Michael-Q-Ly/PlantHumidifier/Hardware/PlantHumidifier/Images/Ducky.bmp

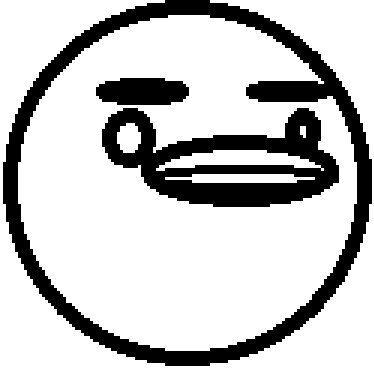
Hardware/PlantHumidifier/Images/Ducky.bmp
