Michael-Q-Ly/PlantHumidifier/Hardware/PlantHumidifier/PlantHumidifier.kicad_pcb

## KiCad design Hardware/PlantHumidifier/PlantHumidifier.kicad_pcb (2023-01-14)

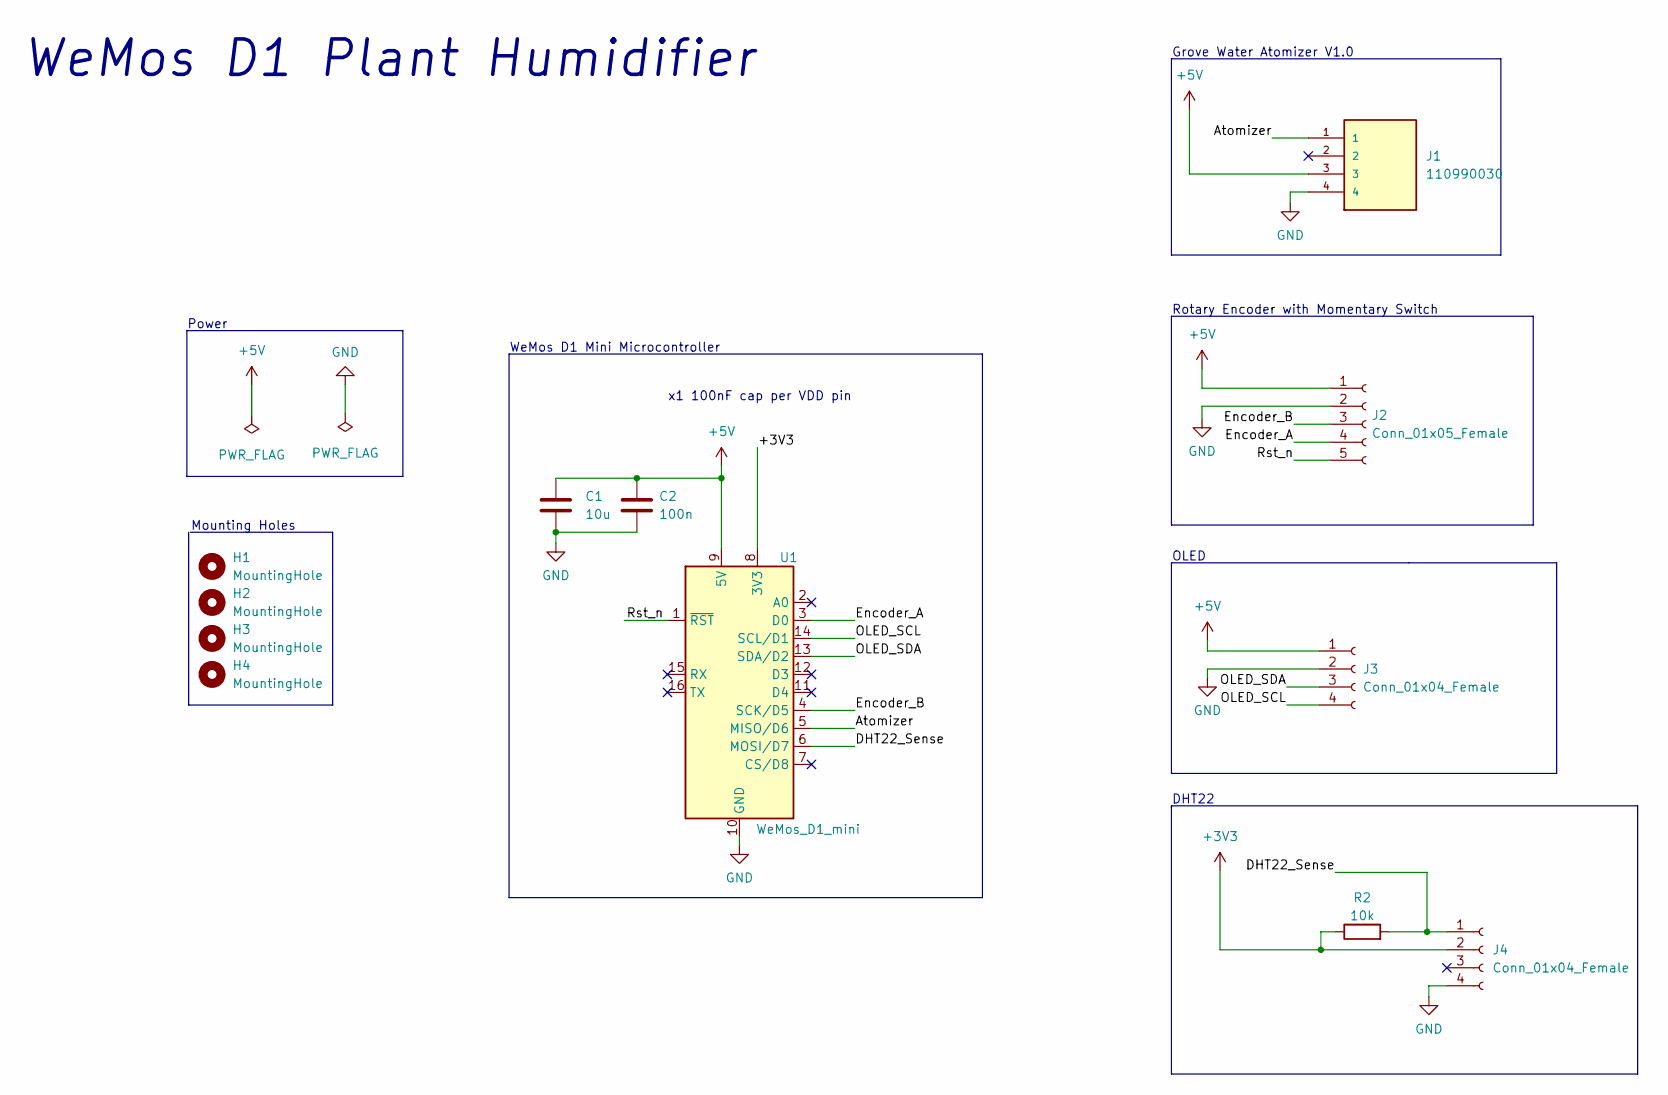
[picture p2: schematic PlantHumidifier.kicad_sch, Plant Humidifier]

Parts:
C1: 10u; C_0603_1608Metric
C2: 100n; C_0402_1005Metric
H1, H2, H3, H4: MountingHole; MountingHole_2.2mm_M2
J1: 110990030; SEEED_110990030; PARTREV A
J2: Conn_01x05_Female; JST_XH_B5B-XH-A_1x05_P2.50mm_Vertical
J3, J4: Conn_01x04_Female; JST_XH_B4B-XH-A_1x04_P2.50mm_Vertical
R2: 10k; R_0402_1005Metric
U1: WeMos_D1_mini; WEMOS_D1_mini_light

Connections:
+3V3: J4.2, R2.1, U1.8 (3V3)
+5V: C1.1, C2.1, J1.3, J2.1, J3.1, U1.9 (5V)
/Atomizer: J1.1, U1.5 (MISO/D6)
/DHT22_Sense: J4.1, R2.2, U1.6 (MOSI/D7)
/Encoder_A: J2.4, U1.3 (D0)
/Encoder_B: J2.3, U1.4 (SCK/D5)
/OLED_SCL: J3.4, U1.14 (SCL/D1)
/OLED_SDA: J3.3, U1.13 (SDA/D2)
/Rst_n: J2.5, U1.1 (~RST)
GND: C1.2, C2.2, J1.4, J2.2, J3.2, J4.4, U1.10 (GND)

Notes on the sheet:
x1 100nF cap per VDD pin
Rotary Encoder with Momentary Switch
OLED
DHT22
Grove Water Atomizer V1.0
WeMos D1 Mini Microcontroller
Power
Mounting Holes
WeMos D1 Plant Humidifier

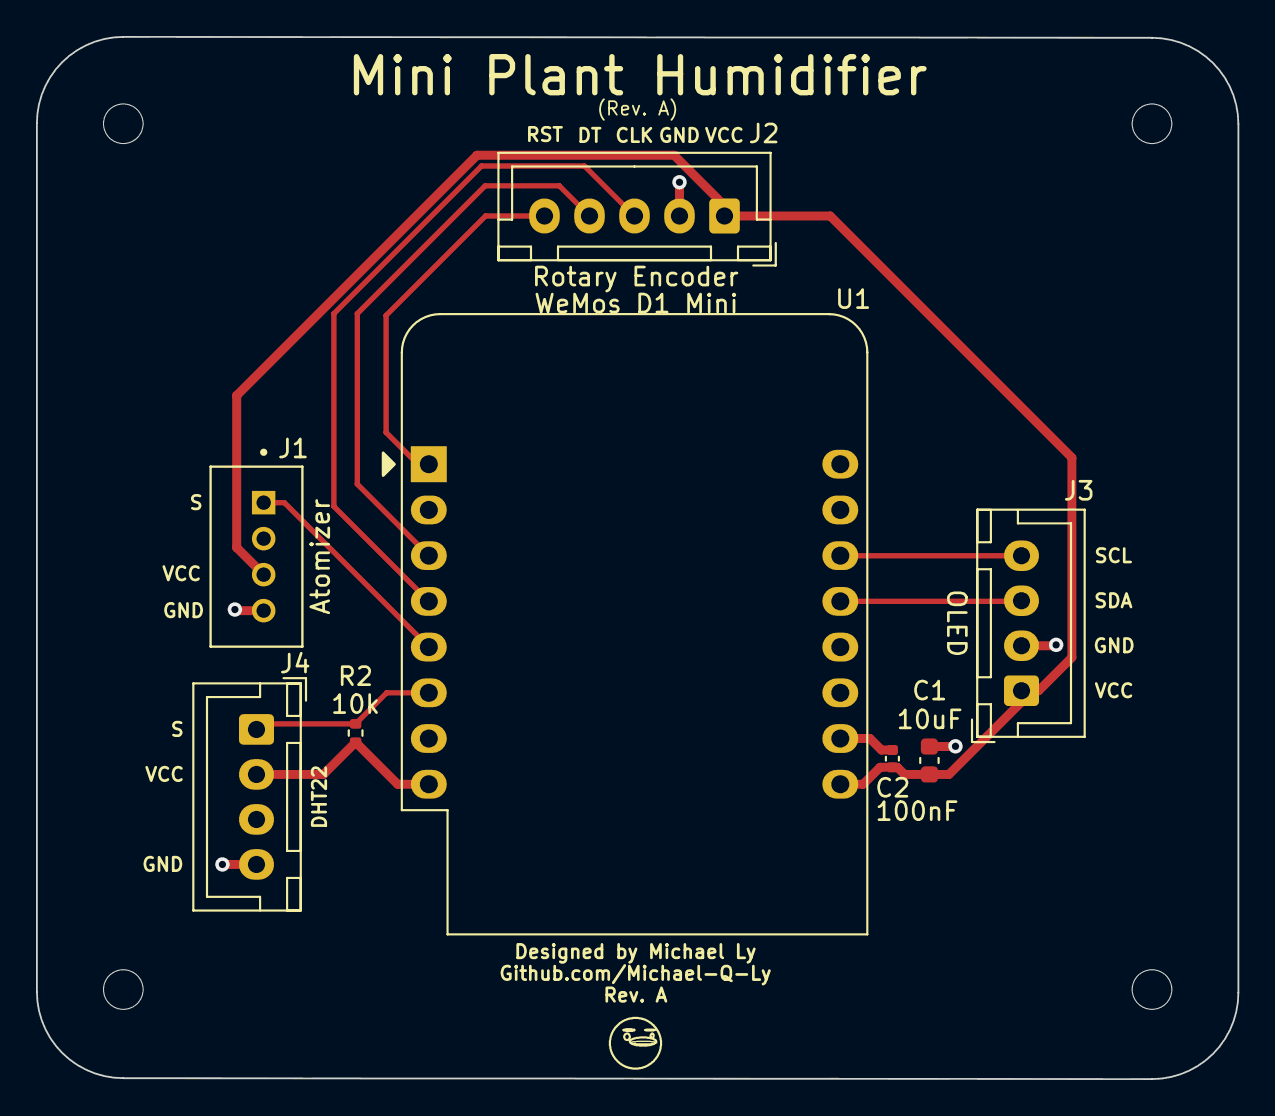
[picture p3: board PlantHumidifier.kicad_pcb from above]

Board: 2 copper layers, 66.8 x 57.9 mm, 12 parts (0 on the bottom side), 10 nets.
