Michael-Q-Ly/PlantHumidifier/include/atomizer.hpp

/*
 * =====================================================================================
 *
 *       Filename:  atomizer.hpp
 *
 *    Description:  Water atomizer header file 
 *
 *        Version:  1.0
 *        Created:  01/08/2023 02:48:25 PM
 *       Revision:  none
 *       Compiler:  g++
 *
 *         Author:  Michael Ly
 *   Organization:  
 *
 * =====================================================================================
 */
#ifndef ATOMIZER_HPP
#define ATOMIZER_HPP
#include "main.hpp"

enum e_atomizer_state {
	ATOMIZER_ON  = HIGH,
	ATOMIZER_OFF = LOW
} ;

#endif /* ATOMIZER_HPP */
