Michael-Q-Ly/PlantHumidifier/(commit log)

2022-12-31 Add example code from Adafruit for DHT sensors
2023-01-01 Confirm that the OLED screen works with Hello World Message
    - Ensure that the OLED screen VCC line is biased with a minimum
    of ~3.6VDC to 5VDCC. You can use the 5V output of the D1_Mini
    to power it; the 3V line will NOT work
    [main.cpp]
2023-01-02 Show hudmidity, temperature, and heat index on OLED successfully
2023-01-02 Add KiCad to gitignore
2023-01-02 Schematic: start water atomizer schematic
    [Water_Atomizer.kicad_pcb, Water_Atomizer.kicad_sch]
2023-01-03 Copy current project to an example that uses OLED to display DHT data
2023-01-06 Refactor code to use Functions and begin work on encoder
    - The following are now functions:
    - Displaying welcoem screen on OLED
    - Displaying data through OLED
    - Verifying if DHTxx read data correctly
    [main.cpp]
2023-01-08 Add encoder proof of concept
2023-01-08 Finish refactoring functions into separate modules; begin encoder modules
2023-01-08 Get water atomizer to use nonblocking code to turn on
    - Not using some sort of delayed time to turn on and off will
    cause the water atomizer to PWM its on/off time, which will
    not let it pull up to logical value 1 due to average voltage
    level
    - The fix applied here will get millis to use as nonblocking
    code, thus allowing atomizer to turn on for a duration before
    checking condition again
    [dhtxx.hpp, encoder.hpp, main.cpp]
2023-01-09 Begin plant humidifier PCB
    [PlantHumidifier.kicad_pcb, PlantHumidifier.kicad_sch]
2023-01-10 Schematic: Add D1 mini
    [PlantHumidifier.kicad_sch]
2023-01-12 Schematic: Layout connectors for all sensors
    [PlantHumidifier.kicad_sch]
2023-01-12 Schematic: Add filtering caps and wire DHT22
    [PlantHumidifier.kicad_sch]
2023-01-12 Schematic: Wire up OLED screen
    [PlantHumidifier.kicad_sch]
2023-01-12 Schematic: Finish wiring rotary encoder with momentary switch
    [PlantHumidifier.kicad_sch]
2023-01-12 Schematic: Finish wiring Grove water atomizer
    [PlantHumidifier.kicad_sch]
2023-01-12 Schematic: Fix pin connections of sensors
    [PlantHumidifier.kicad_sch]
2023-01-12 Move DHT22 pin in code and schematic to D3 (GPIO 0); GPIO requires removal of DHT b/w resets
    [PlantHumidifier.kicad_sch]
2023-01-12 Exclude autosave files from PCB design in gitignore
2023-01-12 Schematic: Add an active low reset switch
    [PlantHumidifier.kicad_sch]
2023-01-12 Schematic: Add page Title + Info
    [PlantHumidifier.kicad_sch]
2023-01-12 Schematic: Finish adding title and drawing outlines for different modules
    [PlantHumidifier.kicad_sch]
2023-01-12 Schematic: Annotate schematic
    [PlantHumidifier.kicad_sch]
2023-01-12 Schematic: Run and fix DRC + Add power
    [PlantHumidifier.kicad_sch]
2023-01-13 Schematic: Fix switch to momentary switch
    [PlantHumidifier.kicad_sch]
2023-01-13 Schematic: Add footprints (except for water atomizer)
    [PlantHumidifier.kicad_sch]
2023-01-13 Schematic: Add symbol/Footprints for atomizer and finish footprint assignment
    [PlantHumidifier.kicad_sch]
2023-01-13 Layout: Begin Plant Humidifier layout
    [PlantHumidifier.kicad_pcb]
2023-01-13 Schematic: Fix unlabeled part and run ERC again
    [PlantHumidifier.kicad_sch]
2023-01-13 Layout: Update PCB from schematic
    [PlantHumidifier.kicad_pcb]
2023-01-13 Layout: Add board settings for OSH Park
    [PlantHumidifier.kicad_pcb]
2023-01-13 Layout: Route DHT22
    [PlantHumidifier.kicad_pcb]
2023-01-13 Layout: Route OLED screen
    [PlantHumidifier.kicad_pcb]
2023-01-14 Code: Remove encoder switch pin to use as HW reset only and move atomizer and DHT pins around for layout
    [encoder.hpp, main.cpp, main.hpp]
2023-01-14 Schematic: Reflect changes in pin assignment
    [PlantHumidifier.kicad_sch]
2023-01-14 Layout: Reflect new pin changes
    [PlantHumidifier.kicad_pcb]
2023-01-14 Change pin assignment for OLED for better routing
    [PlantHumidifier.kicad_pcb, PlantHumidifier.kicad_sch]
2023-01-14 Layout: Route OLED
    [PlantHumidifier.kicad_pcb]
2023-01-14 Update pins again for easier routing (reflected in layout + schematic here as well)
    [PlantHumidifier.kicad_pcb, PlantHumidifier.kicad_sch]
2023-01-14 Layout: Route encoder and atomizer
    [PlantHumidifier.kicad_pcb]
2023-01-14 Layout: Route power and ground rails
    [PlantHumidifier.kicad_pcb]
2023-01-14 Schematic: Add mounting holes (Size M2)
    [PlantHumidifier.kicad_sch]
2023-01-14 Layout: Make edge cuts
    [PlantHumidifier.kicad_pcb]
2023-01-14 Layout: Add copper pour
    [PlantHumidifier.kicad_pcb]
2023-01-14 Layout: Fix all DRC errors
    [PlantHumidifier.kicad_pcb]
2023-01-14 Layout: Center Encoder
    [PlantHumidifier.kicad_pcb]
2023-01-14 Layout: Add silkscreen values, headers, & values
    [PlantHumidifier.kicad_pcb]
2023-01-14 Schematic: Update annotations
    [PlantHumidifier.kicad_sch]
2023-01-14 Add custom Ducky image and footprint
2023-01-14 Layout: Add silkscreen title and relevant information about design
    [PlantHumidifier.kicad_pcb]
2023-01-14 Layout: Generate manufacturing files such as BOM, position, gbr, and drill files
    [PlantHumidifier-B_Cu.gbr, PlantHumidifier-B_Mask.gbr, PlantHumidifier-B_Paste.gbr, PlantHumidifier-B_Silkscreen.gbr, PlantHumidifier-Edge_Cuts.gbr, PlantHumidifier-F_Cu.gbr, PlantHumidifier-F_Mask.gbr, PlantHumidifier-F_Paste.gbr]
